chinmaya2/Design-3D-Printing-of-a-Model---Washington-State-University/Final_Part.sldprt

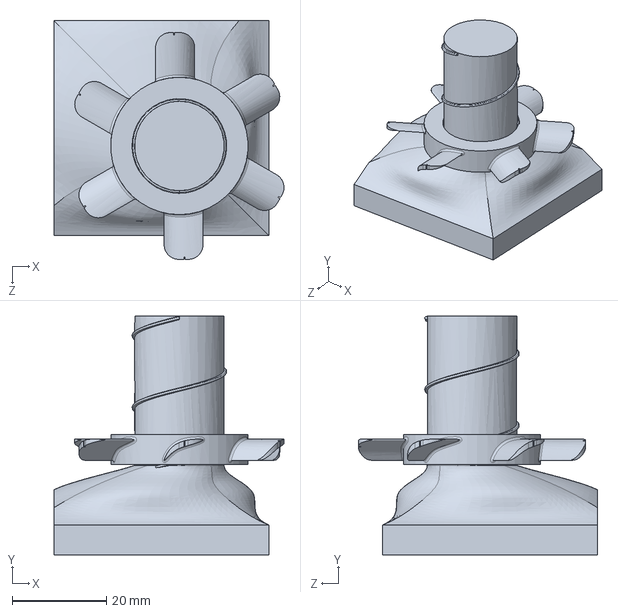
[picture p4: CAD file, 2019-08-30]
Final_Part.sldprt
48.9 x 50.8 x 50.8 mm
