chinmaya2/Design-3D-Printing-of-a-Model---Washington-State-University/Hands on Project Rev 2 DWG.PDF

6

5

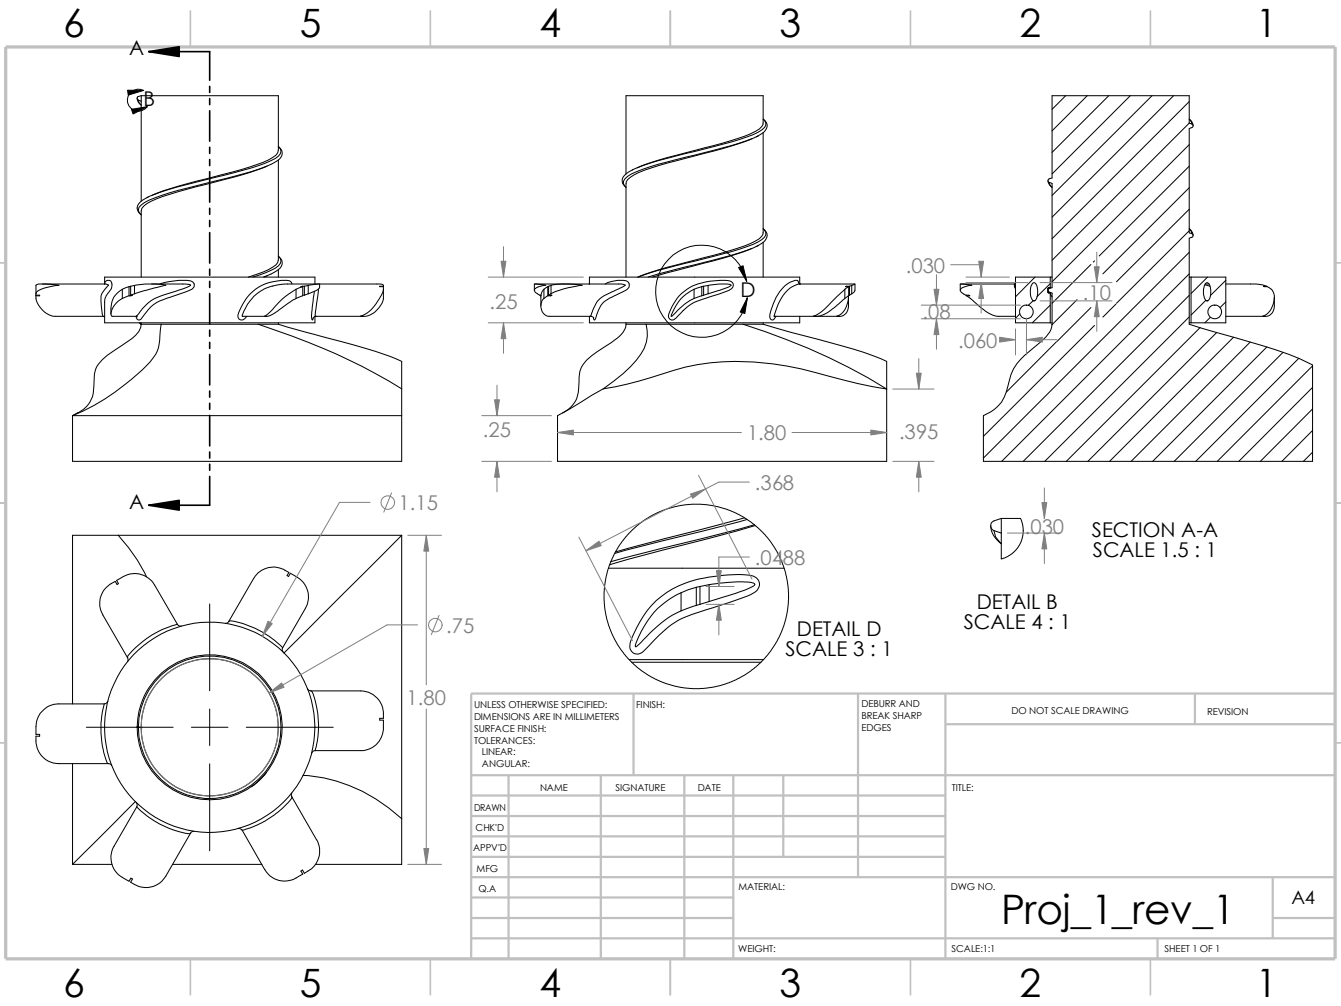
[picture p5: page 1]
WEIGHT:; SCALE:1:1; SHEET 1 OF 1; FINISH:; EDGES; DO NOT SCALE DRAWING; REVISION; DEBURR AND BREAK SHARP; DETAIL B SCALE 4 : 1; DETAIL D SCALE 3 : 1; SECTION A-A SCALE 1.5 : 1

UNLESS OTHERWISE SPECIFIED:
DIMENSIONS ARE IN MILLIMETERS
SURFACE FINISH:
TOLERANCES:
LINEAR:
ANGULAR:

NAME | SIGNATURE | DATE | | | | TITLE:

DRAWN
CHK'D
APPV'D
Q.A | | | | MATERIAL: | DWG NO. Proj_1_rev_1 | A4

MFG
